GhanGhan/Robot_Smart_Car/Documents/Bill of Materials.xlsx

Sheet: Parts used Over Pro.Dev Cycle
Part Name | Details | Purpose | Price | Quantity | Cost | Link
YIKESHU 2WD Smart Robot Car | Robot chassis | Platform for differential drive | $17.00 | 1 | $17.00 | https://www.amazon.ca/YIKESHU-Smart-Robot-Encoder-Battery/dp/B073VHQT6P
Perseids Robot Car Chassis Kit | Robot chassis | Provided second layer to support electronics | $22.29 | 1 | $22.29 | https://www.amazon.ca/gp/product/B0746GQF56/ref=ppx_yo_dt_b_asin_title_o01_s00?ie=UTF8&psc=1
TT Motor with Encoder | DC motor and quadrature encoder | DC motor to Drive robot and sense velocity with encoders | $7.40 | 1 | $7.40 | https://www.dfrobot.com/product-1457.html
L298N Motor Drive Controller | DC motor driver | Control input voltage to DC motors | $13.99 | 1 | $13.99 | https://www.amazon.ca/gp/product/B07C4B3DL4/ref=ppx_yo_dt_b_asin_title_o06_s00?ie=UTF8&psc=1
Gikfun Mini Micro Jumper for Arduino (Pack of 50pcs) | Hardware jumper | Allow Motor driver to power logic circuitry | $7.88 | 1 | $7.88 | https://www.amazon.ca/gp/product/B06XGSZ91M/ref=ppx_yo_dt_b_asin_title_o00_s00?ie=UTF8&psc=1
Dayana Improved ATMEGA328P UNO | Microcontroller 1 | Arduino Uno for product development | $14.99 | 1 | $14.99 | https://www.amazon.ca/gp/product/B08PB5LYRL/ref=ppx_yo_dt_b_asin_title_o06_s02?ie=UTF8&psc=1
Elegoo MEGA 2560 R3 Board ATmega2560 | Microcontroller 2 | Arduino Mega, used for multiple serial ports | $22.99 | 1 | $22.99 | https://www.amazon.ca/gp/product/B01H4ZLZLQ/ref=ppx_yo_dt_b_asin_title_o06_s00?ie=UTF8&psc=1
Arduino Due [A000062] Board | Microcontroller 3 | Used to design control system in Simulink | $56.49 | 1 | $56.49 | https://www.amazon.ca/gp/product/B00A6C3JN2/ref=ppx_yo_dt_b_asin_title_o02_s00?ie=UTF8&psc=1
30W Universal Adapter Power Supply | Variable power supply 3-12V | Apply variable power to the motor driver for testing | $21.99 | 1 | $21.99 | https://www.amazon.ca/gp/product/B08ZN9PF6P/ref=ppx_yo_dt_b_asin_title_o02_s00?ie=UTF8&psc=1
Rechargeable Ni-Mh Battery AA X 8 (4+4) 2400mAh 9.6V | DC motor power supply | Power motor for mobile operation | $29.99 | 1 | $29.99 | https://www.amazon.ca/gp/product/B07WDF51PT/ref=ppx_yo_dt_b_asin_title_o04_s00?ie=UTF8&psc=1
EBL USB Rechargeable 9V Li-ion Batteries (4 Pack) | Arduino power supply | Power Arduino for mobile operation | $27.99 | 1 | $27.99 | https://www.amazon.ca/gp/product/B08X37LHPX/ref=ppx_yo_dt_b_asin_title_o08_s00?ie=UTF8&psc=1
Gikfun 9v Battery Holder with ON/Off Switch for Arduino (Pack of 2) | N/A | Hold Arduino Battery | $9.98 | 1 | $9.98 | https://www.amazon.ca/gp/product/B07G583G88/ref=ppx_yo_dt_b_asin_title_o08_s00?ie=UTF8&psc=1
LAMPVPATH (Pack of 2) 9v Battery Case, with switch | N/A | Connect motor power supply to driver | $9.99 | 1 | $9.99 | https://www.amazon.ca/gp/product/B07T83B4SW/ref=ppx_yo_dt_b_asin_title_o07_s00?ie=UTF8&psc=1
OliYin 3pairs Tamiya Plug Male Female Connector 14awg | N/A | Connect motor power supply to driver | $16.98 | 1 | $16.98 | https://www.amazon.ca/gp/product/B0746GQF56/ref=ppx_yo_dt_b_asin_title_o01_s00?ie=UTF8&psc=1
Aligator Clips | N/A | Connect motor power supply to driver |  | 2 | $0.00 | Pre-owned
Heat Shrink | N/A | Cover soldered wire connections |  | 1 | $0.00 | Pre-owned
400 Tie-Points Breadboard | N/A | Host LED's resistors, wires and Bluetooth module |  | 1 | $0.00 | Pre-owned
DAOKI 2Pcs HC-06 Bluetooth Module | N/A | Allow robot to be controlled over Bluetooth | $15.99 | 1 | $15.99 | https://www.amazon.ca/gp/product/B08213W3BS/ref=ppx_yo_dt_b_asin_title_o01_s00?ie=UTF8&psc=1
Slider Switch | N/A | Switch between USB/Bluetooth control |  | 1 | $0.00 | Pre-owned
Green LED | N/A | Indicates Bluetooth Control Mode |  | 1 | $0.00 | Pre-owned
Red LED | N/A | Indicates USB Control Mode |  | 1 | $0.00 | Pre-owned
2.2k ohm resistor | N/A | Part of Bluetooth programming circuit |  | 1 | $0.00 | Pre-owned
1k ohm resistor | N/A | Part of Bluetooth programming & Red LED circuit |  | 2 | $0.00 | Pre-owned
470 ohm resistor | N/A | Part of Green LED cicuit |  | 1 | $0.00 | Pre-owned
100 ohm resistor | N/A | Part of Bluetooth programming circuit |  | 1 | $0.00 | Pre-owned
Jumper Wires | N/A | Connect io poorts and power supplies | $10.59 | 1 | $10.59 | https://www.amazon.ca/gp/product/B01M1IEUAF/ref=ppx_yo_dt_b_asin_title_o03_s00?ie=UTF8&psc=1
Sum |  |  |  |  | $306.53
Total With Tax |  |  |  |  | $346.38

Sheet: Parts bought but not used
Part Name | Details | Intended Purpose | Price | Quantity | Cost | Link
2pcs DC-DC Buck Voltage Converters | Adjustable Step down DC Convertor | Step down supply voltage for motor driver | $10.29 | 1 | $10.29 | https://www.amazon.ca/gp/product/B074J4DLWQ/ref=ppx_od_dt_b_asin_title_s00?ie=UTF8&psc=1
22 Gauge Wire Solid Core Hookup Wires |  | Connections for breadboard circuit | $17.02 | 1 | $17.02 | https://www.amazon.ca/gp/product/B088KQFHV7/ref=ppx_od_dt_b_asin_title_s00?ie=UTF8&psc=1
FULARR 3Pcs Premium 400 Tie-Points Breadboard Set |  | Connect robot electronics | $10.90 | 1 | $10.90 | https://www.amazon.ca/gp/product/B07PCSQ9PN/ref=ppx_od_dt_b_asin_title_s00?ie=UTF8&psc=1
Sum |  |  |  |  | $38.21
Total With Tax |  |  |  |  | $43.18

Sheet: Tools and Misc
Part Name | Price | Quantity | Cost | Link
Test Leed Set & Alligator Clips | $10.99 | 1 | $10.99 | https://www.amazon.ca/gp/product/B06XX25HFX/ref=ppx_od_dt_b_asin_title_s00?ie=UTF8&psc=1
Heat Gun | $21.99 | 1 | $21.99 | https://www.amazon.ca/gp/product/B07P5WFHJ7/ref=ppx_od_dt_b_asin_title_s00?ie=UTF8&psc=1
Electrical Tape | $12.05 | 1 | $12.05 | https://www.amazon.ca/gp/product/B07YDRY8ZS/ref=ppx_yo_dt_b_asin_title_o06_s02?ie=UTF8&psc=1
Sum |  |  | $45.03
Total With Tax |  |  | $50.88

Sheet: Cost of Everything
Category | Cost (with tax)
Parts Used over Product Development Cycle | $346.38
Parts bought but not used | $43.18
Tools and Misc | $50.89
Total Cost of Everything | $440.45
