GhanGhan/Robot_Smart_Car/Documents/Response Test.xlsx

Sheet: Data In
Data In (From Arduino Mega 2560 (COM6)) |  |  |  |  |  |  |  |  |  |  | l0
Data coming from the current data source will appear below as it is received.
Current Data
TIME | Left Wheel | Right Wheel | Linear Speed | Angular Sped | CH5 | CH6 | CH7 | CH8 | CH9 | CH10
20:03:05 | 29.69 | 29.69 | 30 | 0
Historical Data
TIME | Left Wheel | Right Wheel | Linear Speed | CH4 | CH5 | CH6 | CH7 | CH8 | CH9 | CH10
20:02:54 | 0 | 0 | 0 | 0
20:02:54 | 0 | 0 | 0 | 0
20:02:54 | 0 | 0 | 0 | 0
20:02:54 | 0 | 0 | 0 | 0
20:02:54 | 0 | 0 | 0 | 0
20:02:54 | 0 | 0 | 0 | 0
20:02:54 | 0 | 0 | 0 | 0
20:02:54 | 0 | 0 | 0 | 0
20:02:54 | 0 | 0 | 0 | 0
20:02:54 | 0 | 0 | 0 | 0
20:02:54 | 0 | 0 | 0 | 0
20:02:54 | 0 | 0 | 0 | 0
20:02:54 | 0 | 0 | 0 | 0
20:02:54 | 0 | 0 | 0 | 0
20:02:54 | 0 | 0 | 0 | 0
20:02:54 | 0 | 0 | 0 | 0
20:02:54 | 0 | 0 | 0 | 0
20:02:54 | 0 | 0 | 0 | 0
20:02:54 | 0 | 0 | 0 | 0
20:02:54 | 0 | 0 | 0 | 0
20:02:54 | 0 | 0 | 0 | 0
20:02:54 | 0 | 0 | 0 | 0
20:02:54 | 0 | 0 | 0 | 0
20:02:54 | 0 | 0 | 0 | 0
20:02:54 | 0 | 0 | 0 | 0
20:02:54 | 0 | 0 | 0 | 0
20:02:54 | 0 | 0 | 0 | 0
20:02:54 | 0 | 0 | 0 | 0
20:02:54 | 0 | 0 | 0 | 0
20:02:54 | 0 | 0 | 30 | 0
20:02:54 | 3.13 | 4.69 | 30 | 0
20:02:54 | 17.19 | 15.63 | 30 | 0
20:02:54 | 25 | 23.44 | 30 | 0
20:02:54 | 29.69 | 26.56 | 30 | 0
20:02:54 | 29.69 | 28.12 | 30 | 0
20:02:55 | 28.12 | 29.69 | 30 | 0
20:02:55 | 26.56 | 28.12 | 30 | 0
20:02:55 | 25 | 25 | 30 | 0
20:02:55 | 25 | 25 | 30 | 0
20:02:55 | 25 | 23.44 | 30 | 0
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
20:03:05 | 29.69 | 29.69 | 30 | 0
20:03:05 | 29.69 | 29.69 | 30 | 0
20:03:05 | 29.69 | 29.69 | 30 | 0
20:03:05 | 31.25 | 29.69 | 30 | 0
20:03:05 | 29.69 | 29.69 | 30 | 0
20:03:05 | 29.69 | 29.69 | 30 | 0
20:03:05 | 29.69 | 29.69 | 30 | 0
20:03:05 | 29.69 | 29.69 | 30 | 0

Sheet: Data Out
Data Out (To Device)
Data entered into the channels below will be sent to the currently connected device as a comma-delimited string.
CH1 | CH2 | CH3 | CH4 | CH5 | CH6 | CH7 | CH8 | CH9 | CH10
l0

Sheet: Settings
Workbook Settings
Settings below will affect how data is read into the current workbook from data sources. Clear a field's contents to revert to its default setting.
Data interval (ms) | 150 | 10
Data rows | 15 | 500
Data channels | 10 | 10
Data orientation | Newest last | Newest last
WARNING: Changing settings may result in the loss of content and/or custom formatting in the Data In and Data Out worksheets. Always save before changing values.

Sheet: Manifest
Arduino Mega 2560 |  |  |  |  |  |  |  |  | {"Channels":[{"Description":null,"Id":null,"IsGhost":false,"Name":null,"Status":"Active","SubChannels":[{"Description":null,"Id":"CH1","IsGhost":false,"Name":"CH1","Status":"Active","SubChannels":[],"UnitOfMeasure":null},{"Description":null,"Id":"CH2","IsGhost":false,"Name":"CH2","Status":"Active","SubChannels":[],"UnitOfMeasure":null},{"Description":null,"Id":"CH3","IsGhost":false,"Name":"CH3","Status":"Active","SubChannels":[],"UnitOfMeasure":null},{"Description":null,"Id":"CH4","IsGhost":false,"Name":"CH4","Status":"Active","SubChannels":[],"UnitOfMeasure":null},{"Description":null,"Id":"CH5","IsGhost":false,"Name":"CH5","Status":"Active","SubChannels":[],"UnitOfMeasure":null},{"Description":null,"Id":"CH6","IsGhost":false,"Name":"CH6","Status":"Active","SubChannels":[],"UnitOfMeasure":null},{"Description":null,"Id":"CH7","IsGhost":false,"Name":"CH7","Status":"Active","SubChannels":[],"UnitOfMeasure":null},{"Description":null,"Id":"CH8","IsGhost":false,"Name":"CH8","Status":"Active","SubChannels":[],"UnitOfMeasure":null},{"Description":null,"Id":"CH9","IsGhost":false,"Name":"CH9","Status":"Active","SubChannels":[],"UnitOfMeasure":null},{"Description":null,"Id":"CH10","IsGhost":false,"Name":"CH10","Status":"Active","SubChannels":[],"UnitOfMeasure":null}],"UnitOfMeasure":null}],"Commands":[],"DataInterval":150,"Id":"AA3189B6-47A8-435D-9FCB-A6C92C1E058A","IsGenerated":true,"Name":"Arduino Mega 2560","Version":null,"BaudRate":9600}
This manifest was generated for the connected device. You can edit the device name and channel data here and the Data In worksheet will be updated.
 | Channels
 |  |  |  |  |  |  | Data Source Id
 |  | Id | Name | Description | Unit of Measure | Active | AA3189B6-47A8-435D-9FCB-A6C92C1E058A | 1
 |  | CH1 | CH1 |  |  | ü | Data Interval (ms)
 |  | CH2 | CH2 |  |  | ü | 150
 |  | CH3 | CH3 |  |  | ü | Baud Rate
 |  | CH4 | CH4 |  |  | ü | 9600
 |  | CH5 | CH5 |  |  | ü
 |  | CH6 | CH6 |  |  | ü
 |  | CH7 | CH7 |  |  | ü
 |  | CH8 | CH8 |  |  | ü
 |  | CH9 | CH9 |  |  | ü
 |  | CH10 | CH10 |  |  | ü
