GhanGhan/Robot_Smart_Car/src/main.cpp

#include <Arduino.h>
#include "PID.h"
#include "MotorDriver.h"
#include "Encoder.h"
#include "SerialInputParsing.h"

// TIME (INTERVAL) PARAMETERS 
const int delayTime = 20;
const int mills = 1000;

// PID CONTROL PARAMETERS
const float KP = 5.75;    // Proportional Feedback
const float KI = 7;       // Integral Feedback
const float KD = 0.02;    // Derivative feedback

PID controlWheelLeft = PID(KP, KI, KD, -255, 255, delayTime);
PID controlWheelRight = PID(KP, KI, KD, -255, 255, delayTime);

//MOTOR CONTROL PARAMETERS
//PWM pins for MotorA and MotorB respectively.  They control the motor speed.
const int enableLeft = 10; //Enable A
const int enableRight = 9;//Enable B
//Input Pins for MotorA and B.  They control the direction of the motors
const int in1 = 5;//Inputs for Motor A
const int in2 = 4;
const int in3 = 7;//Inputs for Motor B
const int in4 = 6;
MotorDriver motorL = MotorDriver(in1, in2, enableLeft);
MotorDriver motorR = MotorDriver(in3, in4, enableRight);

//ENCODER PARAMETERS
const int Pulses_Per_Rotation = 1920;
//Encoder Index
const int encoderLeft = 0;
const int encoderRight = 1;
//Encoder pins for Motor A
const int encoderLeftA = 2;//A Pin -> the interrupt pin 0
const int encoderLeftB = 8;//B Pin
//Encoder pins for Motor B
const int encoderRightA = 3;//A Pin -> the interrupt pin 0
const int encoderRightB = 11;//B Pin
Encoder encoderWheelL = Encoder(encoderLeftA, encoderLeftB, Pulses_Per_Rotation, delayTime);
Encoder encoderWheelR = Encoder(encoderRightA, encoderRightB, Pulses_Per_Rotation, delayTime);

//DESIRED AND ACTUAL SPEED VARIABLES
float speedLeft, speedRight, speed;
float rpmL, rpmR;
float rotSpeed, actualRotSpeed;


//ERROR DETECTION BYTES
const int START_BYTE_SPEED = 'a';
const int END_BYTE_SPEED = 'b';
const int START_BYTE_ROT = 'f';
const int END_BYTE_ROT = 'g';

//ROBOT DIMENSION VALUES (CM)
const float R = 3.25; //RADIUS OF THE WHEEL
const float L = 13;   //LENGTH OR ROBOT BASE

//PORT VS BLUETOOTH CONTROL
const int phoneBluetooth = 52;  //checks if have signal to connect to phone via bluetooth
const int serialPort = 53;      //checks if have signal to connect to a serial port via bluetooth or USB
enum controlState {BLUE, SPORT, UND};

//SUPPLAMENTARY FUNCTIONS
void getState(int &state);
void unicycleToDerivative();
void applyControlInput();
void printFromPort(int printErrors = 0, int printRPMs = 1, int printControlSignals = 0);
void printFromBT(int printErrors = 0, int printRPMs = 1, int printControlSignals = 0);

void setup() {
  
  Serial.begin(115200);
  Serial1.begin(115200);
  //Initialize Serial1 Port
  pinMode( 18, INPUT_PULLUP );
  pinMode( 19, INPUT_PULLUP );
  //Communication Source
  pinMode(phoneBluetooth, INPUT);
  pinMode(serialPort, INPUT);
  //Initialize Motor driver
  motorL.mdInit();
  motorR.mdInit();
  // Set initial rotation direction
  motorL.setMotorForward();
  motorR.setMotorForward();
  //Initialize the Motor Encoders
  encoderWheelL.EncoderInit(encoderLeft, 0);
  encoderWheelR.EncoderInit(encoderRight, 0);

  speedLeft = 0; speedRight = 0; speed = 0;
  rpmL = 0; rpmR = 0;
  rotSpeed = 0;
  actualRotSpeed = 0;
}

void loop() {
  int state;
  getState(state);
  int num = Serial.available();
  int recievedVal = Serial.read();
  int num1 = Serial1.available();
  int recievedValBT = Serial1.read();
  //////////%%%%%%%%%%% GET SPEED (cm/s) AND OMEGA (deg/second)
  switch(state){
    case BLUE:
    ///---------------FOR BLUETOOTH CONNECTION!!!!!!!
      if(num1 > 0)
      {
        if(recievedValBT == START_BYTE_SPEED)
        {
          int tempSpeed;
          tempSpeed = getSpeed_BT(num1);
          char dig = Serial1.read();
          if(dig == END_BYTE_SPEED && tempSpeed <= 130 && tempSpeed >= -130){
            speed = tempSpeed;
          }
          else{}
          Serial1.read();//to get the carriage return byte
        }// end if statement -- PHONEBLUETOOTH
        
        if(recievedValBT == START_BYTE_ROT)
        {
          int tempRot;
          tempRot = getRot_BT(num1);
          char dig = Serial1.read();
          if(dig == END_BYTE_ROT && tempRot <= 360 && tempRot >= -360){
            rotSpeed = tempRot;
          }
          else{}
          Serial1.read();//to get the carriage return byte
        }// end if statement -- PHONEBLUETOOTH
      }
      break;
    case SPORT:
    ///---------------FOR SERIAL PORT CONNECTION (USB/BLUETOOTH) CONNECTION!!!!!!!
      if(num > 0 )
      {
        if(recievedVal != 'c')
        {
          speed = getSpeed_Port(num, recievedVal);
          speedLeft = speed; speedRight = speed;
          Serial.read();
        }
        else if(recievedVal == 'c')
        {
          rotSpeed = getRot_Port(num, recievedVal);
          Serial.read();
        }
      }
      break;
    case UND:
      Serial.println("Error Undefined State");
      Serial1.println("Error Undefined State ");
  }//end switch case

  if(state == BLUE || state == SPORT)
  {  
    unicycleToDerivative(); // calculate desired left and right wheel speeds from robot linear and angular speeds

    //Get Current Velocities
    rpmL = encoderWheelL.getRPM();
    rpmR = encoderWheelR.getRPM();
    actualRotSpeed = (rpmR-rpmL)*1.5;
    
    if(speedLeft == 0 && speedRight == 0){
      controlWheelLeft.setErrorInt_DerToZero();
      controlWheelRight.setErrorInt_DerToZero();
    }
    controlWheelLeft.calcControl(speedLeft, rpmL);
    controlWheelRight.calcControl(speedRight, rpmR);
    
    // Saturate control signal if it goes above/below the largest value for analogWrite
    applyControlInput();

    
  
    //if(digitalRead(serialPort)==HIGH) ---Commented out because I want to be able to plot speed even when connected to Phone
    //{
      printFromPort(0, 1, 1);
    //}

    if(digitalRead(phoneBluetooth)==HIGH)
    {
      printFromBT(0, 1, 0);
    }
    
    encoderWheelL.setPulsesToZeros();
    encoderWheelR.setPulsesToZeros();
  }
  else //state == UND
  {//emergency stop
    motorL.applyControlInput(0);
    motorR.applyControlInput(0);
    Serial.println("Error Undefined State");
    Serial1.println("Error Undefined State ");
  }
  delay(delayTime);
}// END PROGRAM LOOP



void getState(int &state)
{
  if(digitalRead(phoneBluetooth) == HIGH && digitalRead(serialPort) == LOW)
  {
    state = BLUE;
  }
  else if (digitalRead(phoneBluetooth) == LOW && digitalRead(serialPort) == HIGH)
  {
    state = SPORT;
  }
  else
  {
    state = UND;
  }
}

void unicycleToDerivative()
{
  float v = speed*2*PI*R/60; //convert speed (rpm) to (m/s)
  float omega = rotSpeed*PI/180; //convert (deg/s) to (rad/s)

  float vl(0), vr(0);

  vr = (2*v+omega*L)/(2*R);//convert (m/s) to (rad/s)
  vl = (2*v-omega*L)/(2*R);

  speedLeft = 60*vl/(2*PI);// convert rads/s to RPM
  speedRight = 60*vr/(2*PI);
}

void applyControlInput(){
  motorL.applyControlInput(controlWheelLeft.getControl());
  motorR.applyControlInput(controlWheelRight.getControl());
}


void printFromPort(int printErrors, int printRPMs, int printControlSignals){
  if(printErrors == 1){
    Serial.print("Error A: ");
    Serial.print(controlWheelLeft.getError());
    Serial.print(",");
    Serial.print("Error B: ");
    Serial.print(controlWheelRight.getError());
    Serial.print(",");
  }
  
  if(printRPMs == 1){
    Serial.print("RpmL: ");
    Serial.print(rpmL);
    Serial.print(",");
    Serial.print(" RpmR: ");
    Serial.print(rpmR);
    Serial.print(",");
  }
  
  if(printControlSignals == 1){
    Serial.print("Control L: ");
    Serial.print(controlWheelLeft.getControl());
    Serial.print(",");
    Serial.print("Control R: ");
    Serial.print(controlWheelRight.getControl());
    Serial.print(",");
  }

  
  Serial.print(" Rot: ");
  Serial.print(rotSpeed);
  Serial.print(",");

  Serial.print(" ARot: ");
  Serial.print(actualRotSpeed);
  Serial.print(",");

  Serial.print(" SpeedL: ");
  Serial.print(speedLeft);
  Serial.print(",");

  Serial.print(" SpeedR: ");
  Serial.print(speedRight);
  Serial.print(",");
  
  
  Serial.print(" Speed: ");
  Serial.print(speed);
  Serial.println();
}

void printFromBT(int printErrors, int printRPMs, int printControlSignals){
  if(printErrors == 1){
    Serial1.print("Error A: ");
    Serial1.print(controlWheelLeft.getError());
    Serial1.print(",");
    Serial1.print("Error B: ");
    Serial1.print(controlWheelRight.getError());
    Serial1.print(",");
  }
  
  
  if(printControlSignals == 1){
    Serial1.print("Control L: ");
    Serial1.print(controlWheelLeft.getControl());
    Serial1.print(",");
    Serial1.print("Control R: ");
    Serial1.print(controlWheelRight.getControl());
    Serial1.print(",");
  }
  
  

  if(printRPMs == 1){
    Serial1.print("Sent Speed: ");
    Serial1.print(speed);

    /*
    Serial1.print("Left: ");
    Serial1.print(rpmL);
    Serial1.print(",");
    Serial1.print(" Right: ");
    Serial1.print(rpmR);
    Serial1.print(",");*/
    float actualSpeed = (rpmL+rpmR)/2;
    Serial1.print(" Actual Speed: ");
    Serial1.println(actualSpeed);
  }

  Serial1.print("Sent DGS: ");
  Serial1.print(rotSpeed);
  Serial1.print(",");

  Serial1.print(" Actual DGS: ");
  Serial1.println(actualRotSpeed);
}
