GhanGhan/Robot_Smart_Car/wheel_control/wheel_control.ino

#define enA 9
#define enB 10
#define in1 7
#define in2 6

#define in3 5
#define in4 4

int rotDirection = 0;

void setup() {
  // put your setup code here, to run once:
  
  pinMode(enA, OUTPUT);
  pinMode(in1, OUTPUT);
  pinMode(in2, OUTPUT);

  pinMode(enB, OUTPUT);
  pinMode(in3, OUTPUT);
  pinMode(in4, OUTPUT);
  // Set initial rotation direction
  digitalWrite(in1, HIGH);
  digitalWrite(in2, LOW);
  digitalWrite(in3, HIGH);
  digitalWrite(in4, LOW);

}

void loop() {
  // put your main code here, to run repeatedly:
  int speedA = 255;
  int speedB = 255;
  analogWrite(enA, speedA);
  analogWrite(enB, speedB);
  digitalWrite(in1, HIGH);
  digitalWrite(in2, LOW);
  digitalWrite(in3, HIGH);
  digitalWrite(in4, LOW);
  delay(500);
  

}
