GhanGhan/Robot_Smart_Car/(commit log)

2022-01-27 First commit of Robot Smart Car
    [Equipment.xlsx]
2022-01-28 Basic one wheel motor control working
2022-01-29 Basic two wheel motor control working
    [Equipment.xlsx]
2022-01-31 Can enter a speed value for the motors over the serial port
2022-02-01 Set up Encoder for Motor A
2022-02-05 no longer need Cool_Term_Min_Input_Byte_Size, full control over motor speed and direction of both wheels as a pair
    [main.cpp]
2022-02-05 Encoder of motorB is attached and correct speed is read
    [main.cpp]
2022-02-05 Organized the Motor encoder variables and functions into source and header files
2022-02-06 Add PI controller, error is within 15% of desired value for rpms over 50, a few times oscillations won't settle
    [main.cpp]
2022-02-06 Changed delayTime*error(A/B)I to delayTime*error(A/B) in calculation for error(A/B), error now nearly 0, Wheel B still oscillates at some steps inputs or when instructed to stop i.e. desired rpm = 0
    [main.cpp]
2022-02-07 Added Kd term, both wheels now (mostly) globaly stable for all types of inputs
2022-02-07 Switched MotorA power terminals to MotorB's and vice versa, removed Direction true/false in setMotor(A/B)(Reverse/Forward), doing so removed the oscillation issue, corrected function logic for changi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
    [main.cpp]
2022-02-14 Add MATLAB code for controlling the speed of a DC motor with a potentiometer
2022-02-16 Show difference between simulation code on the Arduino Hardware and deploying it
2022-02-16 Impletement OpenLoop Control of DC motor using a potentiometer
2022-02-17 In PlatformIO Project Configuration File create environment for Arduino Mega 2560
2022-02-18 Will use Tachometer Arduino block to get speed of the motor, Interrupt mode will be RISING (instead of CHANGING to avoid aliasing) sample time of 0.02, pulse count/rotation of 96 (instead of 192 to a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
2022-02-22 Added Integral Control to PID
2022-02-22 Added Derivative Part to PID control
2022-02-26 When speed is set to 0, make erro integral and derivative equal to 0, this allows to wheels to stop moving in less time and they will never 'randomly' deviate from a speed of 0
2022-02-27 Corrected calculation for Derivative control, also changed Jp and Ki to give 'smoother' speed output
    [main.cpp]
2022-02-28 Can switch between controlling robot using my phone via bluetooth or via a serial port (using bluetooth or USB) using a hardware switch
2022-03-02 Changed PID constants, turned process of getting speed value into methods, changed Baud rate to 57600, Time Interval on phone app now set to 60 ms
2022-03-02 Add applyControlInput, saturateControlInput, printFromPort, printFromBT, getSpeed_Port and getSpeed_Bt functions
2022-03-03 Can now control linear and angular speed of the robot using phone app via Bluetooth, had to increase app time interval to 100 milliseconds to ensure stable connection
2022-03-08 Tested Arduino Due on Motor Control Encoder and Tachometer version, getting aliasing issues for Tachometer but perfect stable operation for encoder version
2022-03-14 Created PID class
2022-03-15 Create Encoder and MotorDriver classes
2022-03-15 Completed Arduino Due Simulink Model
2022-03-15 Redo of creating Encoder and Motor Driver class, corrected encoder pins for motor B
    [Encoder.cpp, main.cpp]
2022-03-15 Change all encoder/wheel/speed related variables to Left and Right suffixes and made function to get left and right wheel speeds from linear and rotation robot speed
2022-03-22 Use switch case statement to determine if controlled from Serial port0 or Bluetooth via serial port 1
2022-03-22 Get current wheel velocities before calculating and appliying control input
2024-01-07 Add important documents related to performance and cost of the project
    [7_5V Step Responses.xlsx, Bill of Materials.xlsx, Motor Speed Vs PWM and Voltage.xlsx, Response Test.xlsx, Time Metrics.xlsx]
2024-01-07 Update ReadMe.md
    Used └── for platformio.ini
2024-02-07 Update ReadMe.md
    Specify what the PID controllers controls, state gains, notify that I programmed controller from ground up
2024-02-09 Update ReadMe.md
    Added video of Prototyping_Verifying PID response
2024-02-09 Update ReadMe.md
    Embedded Prototyping Verifying PID response as a Youtube Video
2024-02-09 Update ReadMe.md
    Correctly switched video links of videos 1 and 2
2024-02-11 Update ReadMe.md
    Edited images so the Video caption on the image, only use verifying PID and screen recording videos
